GuilhermeBohnstedt/8bits-processor/README.md

# 8bits-processor
Trabalho de Conclusão do Curso de Eletrônica

## Objetivo

Queríamos entender melhor como processadores funcionam internamente. Para isso, estudamos a fundo teorias da computação e lógica booleana. Construímos um processador simples que faz os 4 cálculos básicos da matemática, usando somente portas lógicas e circuitos integrados básicos.

## Interpretador
Criamos também uma linguagem para nosso processador.
A partir de um montador, que também construímos, podemos converter instruções humanamente legíveis para códigos que o processador possa executar.

## Documento
Na pasta docs estão os documentos do projeto.

Documento téorico: [Leia aqui](https://github.com/GuilhermeBohnstedt/discrete-processor/blob/main/docs/doc.pdf)
