GuilhermeBohnstedt/8bits-processor/docs/apresetation.pptx

## Processador Prográmavel com circuitos discretos

Guilherme Bohnstedt
Lucas Seiji Kido

## Objetivo

O nosso projeto é um kit didático, com o objetivo de dar uma noção ao usuário de como funciona os processadores e ter uma pequena noção de programação, e o que acontece com a variável no programa.

## Operações Aritméticas

Todos as operações fundamentais (soma, subtração, multiplicação e divisão) podem ser realizadas utilizando apenas uma operação, a soma.

## Multiplicação

Multiplicação é uma série de somas com o mesmo número.
2 x 3 = 6 0010
2 + 2 + 2 = 6 0010
ou 0010
3 + 3 = 6 0110

## Subtração

Subtração é uma soma de dois números, um positivo e outro negativo. E para transformar um binário positivo em um binário negativo há dois modos de conseguir isso, por complemento de um e por complemento de dois.

## Subtração

- Complemento de Um.
Inverte todos os bits do número.
Ex.
1 - 00000001
-1 - 11111110

## Subtração

- Complemento de Dois.
Inverte todos os bits e soma um.
Ex.
1 - 00000001
-1 - 11111111

## Divisão

Divisão é uma série de subtrações até que o divisor seja maior que o dividendo, o resultado é a quantidade de subtrações realizadas e como a nossa calculadora não devolve valores reais não mexemos no resto.

## Processador

- Somador
- Unidade Lógica
- Controlador de pulsos
- Entrada
- Saída
- Memória

## ULA

É o circuito que só realiza soma em binário de duas variáveis, assim concluindo as operações fundamentais utilizando apenas soma, como mostrado anteriormente.

## Unidade Lógica

Onde realiza as quatro operações lógicas básicas, sim, não , e, ou.

SIM | | Mantem os bits no mesmo estado.
NÃO | | Inverte os bits.
E | | A saída só será 1 se as duas entradas forem 1.
OU | | A saída só será 1 se uma ou ambas entradas forem 1.

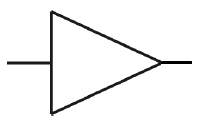
[picture p1: figure]
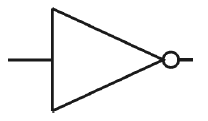
[picture p2: figure]
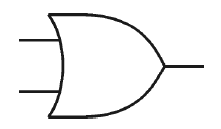
[picture p3: figure]

## Controlador de Pulsos

Controlador de pulsos é um circuito clock, que controla a quantidade que pulsos de clock que será necessário para realizar a operação programada.

## Entrada

Circuito onde o usuário pode colocar os dados manualmente, e dar as instruções que o processador realizará.

## Saída

É o dado em binário devolvido pelo processador das instruções em que ele realizou.

## Memória

O circuito de memória de programa possui uma eeprom que grava o código do programa. Um contador é responsável pela mudança de endereços. E dependendo da instrução esse circuito fica inativo.

## Manipulação dos Dados

Ao inserir os dados manualmente a variável fica registrada nos flip-flops e depois vai para um multiplexador com quatro saídas, uma para cada operação, e então é analisada que tipo de operação vai ser efetuado, ai então será decidido o que realizara com a variável.

## Manipulação de Dados

- Soma
Na soma a primeira variável vai para a ULA onde é somada com a saída que é zero, então obtemos uma saída com o valor da primeira variável. Após isso a segunda variável vai para a ULA onde se repete o processo, mas dessa vez somando a primeira com a segunda variável.

## Manipulação de Dados

- Subtração
A segunda variável é mandada para a ULA onde se realiza o complemento de 1, invertendo todos os bits dela, assim somando com a saída e o dado. Depois o primeiro dado é somado com o primeiro, resultando na saída que é somado com 1, realizando o complemento de 2 e na resposta.

## Manipulação de Dados

- Multiplicação
A primeira variável será quantas vezes a segunda variável será somada, por isso ela será como comparação no comparador. Então a segunda é somada com saída depois disso é incrementada a quantidade de vezes que ira ser somada. Logo depois de incrementar o comparador verifica se às vezes somada é igual ou menor que a primeira variável, se for menor o ciclo ocorre ate que seja igual e se for igual o ciclo acaba e devolve a resposta.

## Manipulação de Dados

- Divisão
A primeira variável será quantas vezes a segunda variável será somada, por isso ela será como comparação no comparador. Então a segunda é somada com saída depois disso é incrementada a quantidade de vezes que ira ser somada. Logo depois de incrementar o comparador verifica se às vezes somada é igual ou menor que a primeira variável, se for menor o ciclo ocorre ate que seja igual e se for igual o ciclo acaba e devolve a resposta.

## Conclusão

Podemos analisar como o processador funciona, assim podemos compreender melhor os circuitos integrados e como manipular os bits, para realizar operações aritméticas. Conseguimos uma noção o que o processador faz com as instruções que lhe é dada. Ter uma experiencia de como construir placas de circuito impresso, e utilizar o software Protheus. Obtivemos um amplo conhecimento de eletrônica digital.

## Referências

- http://www.tecmundo.com.br/tecnologia-da-informacao/1697-a-historia-dos-computadores-e-da-computacao.htm
- http://pt.wikipedia.org/wiki/Computador
- http://www.tecmundo.com.br/eletronica/45954-como-funciona-um-circuito-integrado-ilustracao-.htm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
