GuilhermeBohnstedt/8bits-processor/Interpretador/help2.jpg

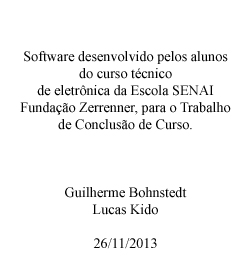
Interpretador/help2.jpg
