GuilhermeBohnstedt/8bits-processor/Interpretador/help.jpg

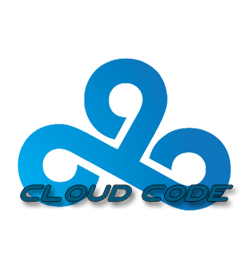
Interpretador/help.jpg
