GuilhermeBohnstedt/8bits-processor/Interpretador/help.png

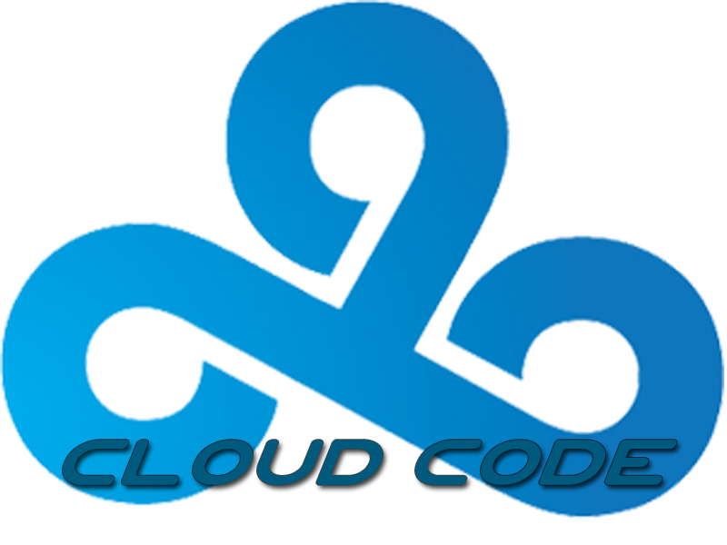
Interpretador/help.png
