GuilhermeBohnstedt/8bits-processor/somador/Somador Final/Somador Final.BMP

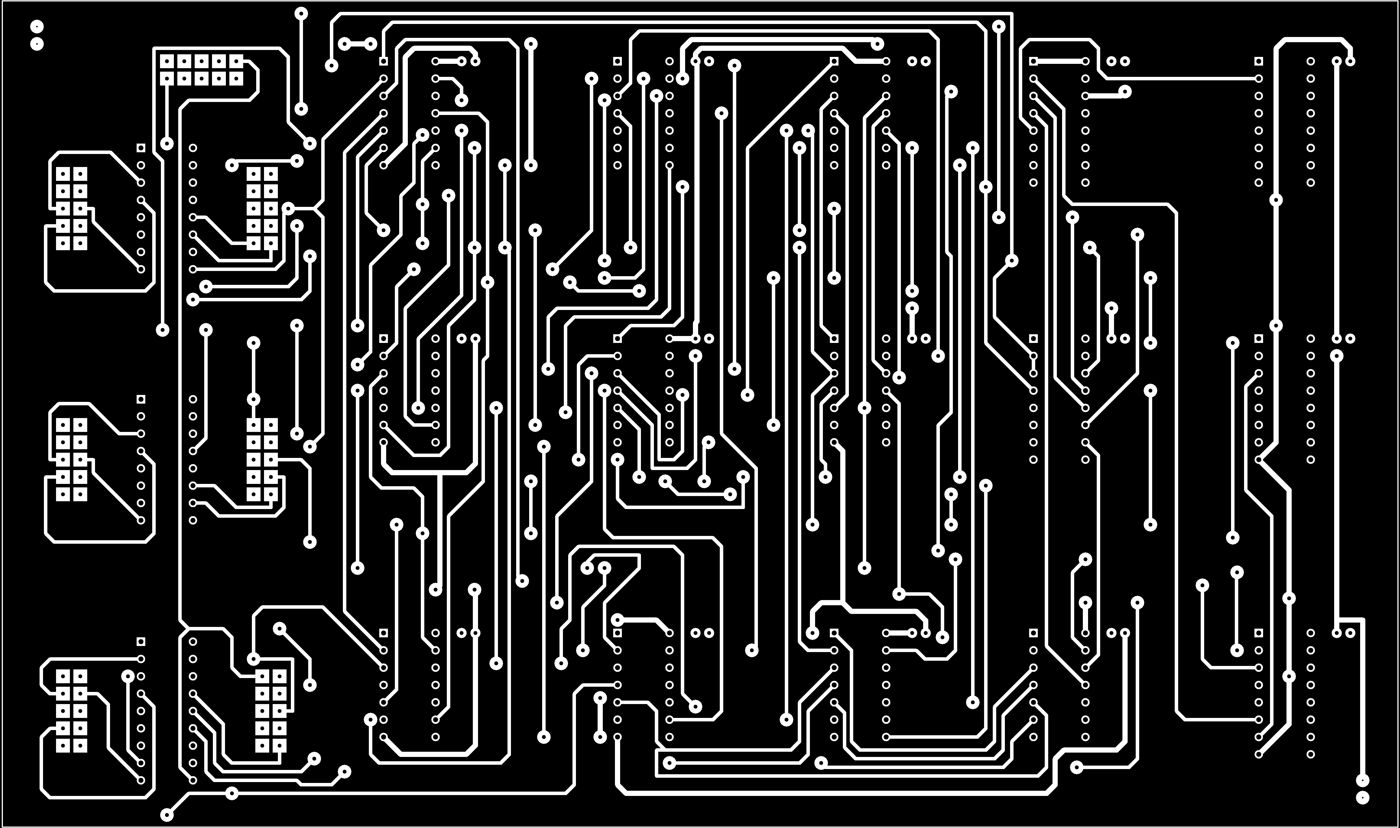
somador/Somador Final/Somador Final.BMP
