GuilhermeBohnstedt/8bits-processor/fonte/FONTE_LISTA_DE_MATERIAL.xls

Sheet: APROV_ EMPREND__NOVO
 |  |  |  |  |  | APROVAÇÃO DO |  |  |  |  |  |  |  |  |  |  |  | NÚMERO DA ATE |  |  |  |  |  |  | FOLHA No
 |  |  |  |  |  | ESTUDO/EMPREENDIMENTO
 |  |  |  |  |  |  |  |  |  |  |  |  |  |  |  |  |  | 9 | 4 | 5 | 0 | 6
ASSUNTO: |  |  | SINALIZAÇÃO INDEVIDA DE LINHA ENERGIZADA (FALHA K75120-K72052-K73503)
LOCAL |  |  |  |  |  |  | ABRANGÊNCIA |  |  |  |  |  | SOLICITANTE |  |  |  |  |  | DATA DA SOLICITAÇÃO
 | PSO |  |  |  |  |  |  | S/E PSO |  |  |  |  |  | GOP/OPT |  |  |  |  |  | 2004-03-10
JUSTIFICATIVA DA NECESSIDADE: |  |  |  |  |  |  |  |  |  |  | NORMALIZAR A SINALIZAÇÃO PARA CONFIABILIDADE DO
 | SISTEMA
CONSEQUÊNCIAS DO NÃO ATENDIMENTO: |  |  |  |  |  |  |  |  |  |  |  | A NÃO OPERACIONALIDADE DO SISTEMA COM
 | SEGURANÇA
ETAPAS PREVISTAS / VALORES ESTIMADOS
ETAPA |  |  |  | EXECUTANTE |  |  |  |  |  |  |  |  |  |  |  | MÃO-DE-OBRA |  |  |  |  |  |  |  | MATERIAL
N0 |  | TIPO |  | COORD. |  |  |  |  | SUPERV. |  |  | EQUIPE |  |  |  | (Hxh) |  |  | (UFESP) |  |  |  |  | (UFESP)
1 |  | AP |  | EPL |  |  |  |  | ELT |  |  |  |  |  |  | 8 |  |  | 32
2 |  | ET |  | EPL |  |  |  |  | ELT |  |  |  |  |  |  | 4 |  |  | 16
3 |  | EX |  | MTE |  |  |  |  | EMN |  |  | PRN |  |  |  | 4 |  |  | 8.84
4 |  | AF |  | EPL |  |  |  |  | ELT |  |  |  |  |  |  | 1 |  |  | 4
5
6
7
8
9
10
 |  |  |  |  |  |  |  |  |  |  |  | TOTAL |  |  |  | 17 |  |  | 60.84 |  |  |  |  | 0
 |  |  |  |  |  |  |  |  |  |  |  | TOTAL GERAL (UFESP) |  |  |  |  |  |  | 60.84
 |  |  |  |  | NÚMERO DO CONTRATO |  |  |  |  |  |  |  |  |  |  | NÚMERO DA OS
PROJETO
EXECUÇÃO
EXPECTATIVA DE ATENDIMENTO DO SOLICITANTE: |  |  |  |  |  |  |  |  |  |  |  |  |  |  |  |  |  |  |  | 30 |  | / | 06 |  | / | 04
PREVISÃO DE ENTREGA DO ESTUDO/EMPREENDIMENTO: |  |  |  |  |  |  |  |  |  |  |  |  |  |  |  |  |  |  |  | 30 |  | / | 06 |  | / | 04
COORDENAÇÃO RESPONSÁVEL: |  |  |  |  |  |  |  |  |  | MTC / EPL |  | RESPONSÁVEL: |  |  |  |  | GERSON R17628.5 |  |  |  |  |  |  | 2004-06-03
TIPO DE ATE |  |  |  |  |  |  |  |  |  |  | M.O. P/ESTUDO/PROJETO |  |  |  |  |  | NÍVEL DE APROVAÇÃO
ESTUDO/PROJETO |  |  |  |  |  |  |  |  |  |  | INTERNA |  |  |  |  |  | EPL |  |  |  |  |  | EPL
 |  |  |  |  |  |  |  |  |  |  |  |  |  |  |  |  | EPL |  |  |  |  |  | EPL
APROVAÇÃO
 | ________________ |  |  |  |  |  |  |  | ________________ |  |  |  |  |  | ___________________ |  |  |  |  |  |  | ________________
 | SUPERVISOR |  |  |  |  |  |  |  | COORDENADOR |  |  |  |  |  | CHEFE DE DPTO. |  |  |  |  |  |  | GERENTE
 | ____ /____ / ____ |  |  |  |  |  |  |  | _____ / ____ / ____ |  |  |  |  |  | ____ / ____ / ____ |  |  |  |  |  |  | ____ / ____ / ____

Sheet: PLANEJAMENTO DE ETAPAS_NOVO
 |  |  |  |  |  | PLANEJAMENTO DE ETAPAS |  |  |  |  |  |  |  |  | NÚMERO DA ATE |  |  |  |  |  |  | FOLHA No
 |  |  |  |  |  |  |  |  |  |  |  |  |  |  | 9 | 4 | 5 | 0 | 6
ASSUNTO: |  |  |  | SINALIZAÇÃO INDEVIDA DE LINHA ENERGIZADA (FALHA K75120-K72052-K73503)
LOCAL |  |  |  |  |  |  | ABRANGÊNCIA |  |  |  | SOLICITANTE |  |  |  |  | DATA DA SOLICITAÇÃO
 | PSO |  |  |  |  |  |  | S/E PSO |  |  |  | GOP/OPT |  |  |  |  | 2004-03-10
ETAPAS PREVISTAS / PRAZOS E VALORES ESTIMADOS
ETAPA |  |  |  |  | EXECUTANTE |  |  |  |  | DATA |  |  |  | MÃO-DE-OBRA |  |  |  |  |  |  | MATERIAL
N0 |  | TIPO |  |  | COORD |  | SUP |  | EQUIPE | INÍCIO |  |  | TÉRMINO | (Hxh) |  |  | (UFESP) |  |  |  | (UFESP)
1 |  | AP |  |  | EPL |  | ELT |  |  | 2004-06-03 |  |  | 2004-06-10 | 8 |  |  | 32 |  |  |  | 0
2 |  | ET |  |  | EPL |  | ELT |  |  | 2004-06-10 |  |  | 2004-06-20 | 4 |  |  | 16 |  |  |  | 0
3 |  | EX |  |  | MTE |  | EMN |  | PRN | 2004-06-20 |  |  | 2004-06-25 | 4 |  |  | 8.84 |  |  |  | 0
4 |  | AF |  |  | EPL |  | ELT |  |  | 2004-06-25 |  |  | 2004-06-30 | 1 |  |  | 4 |  |  |  | 0
5 |  |  |  |  |  |  |  |  |  |  |  |  |  | 0 |  |  | 0 |  |  |  | 0
6 |  |  |  |  |  |  |  |  |  |  |  |  |  | 0 |  |  | 0 |  |  |  | 0
7 |  |  |  |  |  |  |  |  |  |  |  |  |  | 0 |  |  | 0 |  |  |  | 0
8 |  |  |  |  |  |  |  |  |  |  |  |  |  | 0 |  |  | 0 |  |  |  | 0
9 |  |  |  |  |  |  |  |  |  |  |  |  |  | 0 |  |  | 0 |  |  |  | 0
10 |  |  |  |  |  |  |  |  |  |  |  |  |  | 0 |  |  | 0 |  |  |  | 0
 |  |  |  |  |  |  |  |  |  | TOTAL |  |  |  | 17 |  |  | 60.84 |  |  |  | 0
 |  |  |  |  |  |  |  |  |  | TOTAL GERAL (UFESP) |  |  |  |  |  |  | 60.84
ANUÊNCIA DOS ENVOLVIDOS
ETAPA |  |  | RESPONSÁVEL
N0 |  |  | REGISTRO |  |  | VISTO |  |  |  |  |  |  |  | DATA
1 |  |  | R 17628-5 |  |  |  |  |  |  |  |  |  |  | 2004-06-03
2 |  |  | R 17628-5 |  |  |  |  |  |  |  |  |  |  | 2004-06-03
3 |  |  | R 02235-1 |  |  |  |  |  |  |  |  |  |  | 2004-06-03
4 |  |  | R 17628-5 |  |  |  |  |  |  |  |  |  |  | 2004-06-03
5
6
7
8
9
10
EXPECTATIVA DE ATENDIMENTO DO SOLICITANTE: |  |  |  |  |  |  |  |  |  |  |  |  |  |  |  |  | 30 |  | / | 06 |  | / | 04
OBSERVAÇÕES:

Sheet: Listas
ETAPAS DOS SGAT |  |  | SUPERVISÕES MTC |  | COORDENAÇÕES MTC |  | ESTAÇÕES
 |  |  |  |  |  |  | N/S
AP | ANÁLISE PRÉVIA |  | PRE | 53232 | MTC / EPL | EPL
ET | ESTUDO TÉCNICO |  | PRM | 53234 | MTC / EPN | EPN | PAT
PR | PROJETO |  | ELT | 53231 | MTC / EPV | EPV | JAB
APM | APROVIS. DE MATERIAL |  | MEC | 53233 | MTC / EPC | EPC | CON
EX | EXECUÇÃO |  | EDP |  |  | CNT | JUD
AF | AVALIAÇÃO FINAL |  |  |  |  |  | SAL
CT | CONTRATAÇÃO |  |  |  |  |  | ARV
VL | VALORAÇÃO |  |  |  |  |  | SCZ
 |  |  |  |  |  |  | VMN
RESPONSÁVEIS |  | RG´S |  | TIPO DE ATE | MÃO DE OBRA |  | ANR
 |  |  |  |  |  |  | PSO
EPL |  |  |  | ESTUDO/PROJETO | INTERNA |  | VGO
CATUTA R05676-0 |  | R05676-0 |  | EMPREENDIMENTO | EXTERNA |  | JQM
 |  |  |  |  |  |  | LIB
PRE |  |  |  |  |  |  | PSE
SASSON R17319-7 |  | R17319-7 |  |  |  |  | BTO
MOITA R13801-4 |  | R13801-4 |  |  |  |  | LUZ
ORIEL R19833-5 |  | R19833-5 |  |  |  |  | TRD
SÉRGIO R19175-6 |  | R19175-6 |  |  |  |  | ARM
NAKO R07896-8 |  | R07896-8 |  |  |  |  | TTE
 |  |  |  |  |  |  | CDU
ELT |  |  |  |  |  |  | SAN
VASCONCELOS R07972-7 |  | R07972-7 |  |  |  |  | JPA
NAKANO R13352-7 |  | R13352-7 |  |  |  |  | PIG
DIMAN R15982-8 |  | R15892-8 |  |  |  |  | TUC
RUBENS R18289-7 |  | R18289-7
REDONDO R18173-4 |  | R18173-4 |  |  |  |  | L/O
LEONEL R15006-5 |  | R15006-5
NASCIMENTO R09308-8 |  | R09308-8 |  |  |  |  | PIT
MAGNO R12401-3 |  | R12401-3 |  |  |  |  | ITQ
ABNER R19031-8 |  | R19031-8 |  |  |  |  | ART
GERSON R17628-5 |  | R17628-5 |  |  |  |  | PCA
LEANDRO R22238-4 |  | R22238-4 |  |  |  |  | VTD
NOBORU R083945 |  | R08394-5 |  |  |  |  | VPA
IVAN R172794 |  | R17279-4 |  |  |  |  | PEN
LIUDI R14678-5 |  | R14678-5 |  |  |  |  | CAR
 |  |  |  |  |  |  | TAT
PRM |  |  |  |  |  |  | BEL
ROBERTO R06120-8 |  | R06120-8 |  |  |  |  | BRE
CAETANO R19804-1 |  | R19804-1 |  |  |  |  | BAS
DAGOBERTO R15547-4 |  | R15547-4 |  |  |  |  | PDS
CARLOS R07780-5 |  | R07780-5 |  |  |  |  | PSE
MARJORIE R14557-6 |  | R14557-6 |  |  |  |  | GBU
 |  |  |  |  |  |  | REP
MEC |  |  |  |  |  |  | CEC
RICARDO R13955-0 |  | R13955-0 |  |  |  |  | DEO
MOYSÉS R02063-3 |  | R02063-3 |  |  |  |  | BFU
EDGARD R15419-2 |  | R15419-2
REINALDO R14906-7 |  | R14906-7 |  |  |  |  | PAULISTA
ROGER R08700-2 |  | R08700-2
CÁSSIO R18955-7 |  | R18955-7 |  |  |  |  | ANR
CAMPELLO R172387 |  | R17238-7 |  |  |  |  | PSO
KAZUO R02014-5 |  | R02014-5 |  |  |  |  | BGD
GABRIEL R22235-0 |  | R22235-0 |  |  |  |  | TRI
 |  |  |  |  |  |  | CNS
CPQ |  |  |  |  |  |  | CLS
MAURO R15554-7 |  | R15554-7 |  |  |  |  | SUM
 |  |  |  |  |  |  | VMD

Sheet: ANÁLISE CRÍTICA
 | ANÁLISE CRÍTICA, VERIFICAÇÃO E VALIDAÇÃO | NÚMERO DA ATE |  |  |  |  | FOLHA No
 |  | 9 | 4 | 5 | 0 | 6
ANÁLISE CRÍTICA
Planejamento:
Resultados:
VERIFICAÇÃO
Planejamento:
Resultados:
VALIDAÇÃO
Planejamento:
Resultados:

Sheet: A_P_ TERCEIROS
 |  |  |  |  |  |  | SOLICITAÇÃO DE |  |  |  |  |  |  |  |  |  |  |  | NÚMERO DA ATE |  |  |  |  |  | FOLHA No
 |  |  |  |  |  |  | ANÁLISE PRÉVIA
 |  |  |  |  |  |  |  |  |  |  | PARA ATE MISTA |  |  |  |  |  |  |  | 9 | 4 | 5 | 0 | 6
DE: |  | ENG. NAKO |  |  |  |  |  |  |  | COORD.: |  |  | EPL |  |  | ÁREA: | PRE |  |  |  |  | DATA: |  | 2002-06-06
PARA: |  |  | ENG. LOVATO |  |  |  |  |  |  |  |  | COORD.: |  | EPC |  |  |  | ÁREA: |  |  | EDP
ASSUNTO: |  |  |  | SINALIZAÇÃO INDEVIDA DE LINHA ENERGIZADA (FALHA K75120-K72052-K73503)
 | 0
 | 0
SERVIÇOS SOLICITADOS: |  |  |  |  |  |  |  |  | CONSTRUÇÃO BASES DE CONCRETO PARA FIXAÇÃO DE 4 POSTES COM
 | ALTURA MÁXIMA DE 3,5M.
DATA LIMITE PARA ENVIO DO PARECER TÉCNICO PELA COORDENAÇÃO RESPONSÁVEL: |  |  |  |  |  |  |  |  |  |  |  |  |  |  |  |  |  |  |  |  |  |  |  |  | / /
VALORES/PRAZOS ESTIMADOS PELO EP ENVOLVIDO:
ETAPA |  |  |  |  | EXECUTANTE |  |  |  |  |  |  |  | DATA |  |  |  |  | MÃO-DE-OBRA |  |  |  |  |  | MATERIAL
N0 |  | TIPO |  |  | COORD |  |  | SUP |  |  | EQUIPE |  | INÍCIO |  |  | TÉRMINO |  | (Hxh) |  |  | (UFESP) |  |  | (UFESP)
1 |  | AP |  |  | EPL |  |  | ELT |  |  | 0 |  | 2004-06-03 |  |  | 2004-06-10 |  | 8 |  |  | 32
2 |  | ET |  |  | EPL |  |  | ELT |  |  | 0 |  | 2004-06-10 |  |  | 2004-06-20 |  | 4 |  |  | 16
3 |  | EX |  |  | MTE |  |  | EMN |  |  | PRN |  | 2004-06-20 |  |  | 2004-06-25 |  | 4 |  |  | 8.84
4 |  | AF |  |  | EPL |  |  | ELT |  |  | 0 |  | 2004-06-25 |  |  | 2004-06-30 |  | 1 |  |  | 4
5 |  | 0 |  |  | 0 |  |  | 0 |  |  | 0 |  | 0 |  |  | 0 |  | 0 |  |  | 0
6 |  | 0 |  |  | 0 |  |  | 0 |  |  | 0 |  | 0 |  |  | 0 |  | 0 |  |  | 0
7 |  | 0 |  |  | 0 |  |  | 0 |  |  | 0 |  | 0 |  |  | 0 |  | 0 |  |  | 0 |  |  | 0
8
9
10
OBSERVAÇÕES:
ANUÊNCIA DO EP ENVOLVIDO
RESPONSÁVEL |  |  |  |  |  |  |  |  |  |  | SUPERVISOR |  |  |  |  |  |  | COORDENADOR
VISTO: |  |  |  |  |  |  |  |  |  |  | VISTO: |  |  |  |  |  |  | VISTO:
REGISTRO: |  |  |  |  |  |  |  |  |  |  | REGISTRO: |  |  |  |  |  |  | REGISTRO:
DATA: |  |  |  |  |  |  |  |  |  |  | DATA: |  |  |  |  |  |  | DATA:
 |  |  | / |  |  | / |  |  |  |  |  |  | / |  | / |  |  |  |  |  |  | / |  | /

Sheet: REM1
 |  |  |  |  |  |  |  |  |  |  | ANEXO No
 |  |  |  |  | LISTA DE MATERIAL
ASSUNTO: |  | FONTE DE TENSÃO C/ SAÍDA REGULÁVEL 0 A 20 Vcc E FIXA DE 5 Vcc E 12 Vcc
Item | Código | Unid | Quant | Descrição |  |  | Valores Estimados(R$) |  | Valores Reais (R$) |  | Disp. Mat.
 |  |  |  |  |  |  | Unitário | Total | Unitário | Total | Previsto | Real
1 | TR1 | PÇA | 1 | TRANSFORMADOR 110/220V 9+9V 2A
2 | Q2 | PÇA | 1 | TRANSISTOR BC 548
3 | Q1 | PÇA | 1 | TRANSISTOR TIP 125 C/ DISSIPADOR DE CALOR E PARAFUSO DE FIXAÇÃO
4 | U1 | PÇA | 1 | REGULADOR DE TENSÃO 7812
5 | U2 | PÇA | 1 | REGULADOR DE TENSÃO 7805
6 | D1 A D9 | PÇA | 9 | DIODO RETIFICADOR 1N4004
7 | DZ1 | PÇA | 1 | DIODO ZENER 1N4747
8 | LED1, LED2 | PÇA | 2 | LED VERMELHO C/ SUPORTE PARA PAINEL
9 | C1 | PÇA | 1 | CAPACITOR ELETROLÍTICO RADIAL 2200 µF – 35V
10 | C4 | PÇA | 1 | CAPACITOR ELETROLÍTICO RADIAL 1000 µF – 35V
11 | C2 | PÇA | 1 | CAPACITOR ELETROLÍTICO RADIAL 10 µF – 25V
12 | C3, C5 | PÇA | 2 | CAPACITOR ELETROLÍTICO RADIAL 0,1 µF – 25V
13 | R4 | PÇA | 1 | RESISTOR 470 Ω- 2W
14 | R1 | PÇA | 1 | RESISTOR 1k8 Ω- 1W
15 | R2 | PÇA | 1 | RESISTOR 470 Ω- 0,5W
16 | R3 | PÇA | 1 | RESISTOR 1k5 Ω- 0,5W
17 | R5 | PÇA | 1 | RESISTOR 3k3 Ω- 0,5W
18 | P1 | PÇA | 1 | POTENCIÔMETRO LINEAR 50 kΩ COM KNOB
19 | FU1 | PÇA | 1 | FUSÍVEL DE VIDRO DE 2A C/ PORTA FUSÍVEL DE PAINEL
20 | CH2 | PÇA | 1 | CHAVE HH 110/220 V
21 | CH1 | PÇA | 1 | CHAVE LIGA DESLIGA SIMPLES PARA PAINEL
22 | B1, B3, B4 | PÇA | 3 | BORNE VERMELHO PARA PAINEL
23 | B2, B5 | PÇA | 2 | BORNE PRETO PARA PAINEL
24 | - | PÇA | 1 | CABO DE ALIMENTAÇÃO (CORDÃO DE FORÇA C/ PLUG)
25 | - | PÇA | 1 | PLACA DE CIRCUITO IMPRESSO COBREADA 1 FACE TAMANHO 12 X 5,5 CM
26 | - | PÇA | 1 | CAIXA PLÁSTICA PARA MONTAGEM DOS COMPONENTES TAMANHO MINIMO 14X9X10 CM |  |  | - | #VALUE!
27 | - | MTR | 1 | CABO DE CONTROLE FLEXIVEL 0,5 MM2 600V |  |  | - | #VALUE!
28 |  | #N/A |  |  |  |  | #N/A
29 |  | #N/A |  |  |  |  | #N/A
30 |  | #N/A |  |  |  |  | #N/A
 |  |  |  |  |  |  |  | #VALUE!
EXECUTANTE |  |  |  |  | NÚMERO | TURMA | COMPONENTE CURRICULAR |  |  | PROFº
 |  |  |  |  |  |  | MSI – II |  |  | GERSON

Sheet: OSES
 |  |  | ORIENTAÇÃO E SEQUÊNCIA DE |  |  |  | NÚMERO DA ATE |  |  |  |  |  | FOLHA No
 |  |  | EXECUÇÃO DE SERVIÇOS
 |  |  | OSES |  |  |  | 9 | 4 | 5 | 0 | 6
ASSUNTO: |  | SINALIZAÇÃO INDEVIDA DE LINHA ENERGIZADA (FALHA K75120-K72052-K73503)
0
0
0
ORIENTAÇÃO E SEQUÊNCIA DE EXECUÇÃO DO SERVIÇO
ITEM | EXECUTANTE COORD/SUP/EQUIP |  | ORIENTAÇÃO (IT,DESENHOS, ETC.) |  |  |  |  |  |  |  | RELAÇÃO DE MATERIAL |  |  | SEQ.
1 | MTE/CCV |  | EXECUTAR INSTALAÇÕES ELÉTRICAS CONFORME |  |  |  |  |  |  |  | REM 1 |  |  | 1
 |  |  | INDICADO NO DES. MTC 2AG002945
2 | MTE/CCV |  | EXECUTAR INSTALAÇÕES ELÉTRICAS CONFORME |  |  |  |  |  |  |  | REM 1 |  |  | 1
 |  |  | INDICADO NO DES. MTC 2AG002945
3 | MTE/CCV |  | EXECUTAR INSTALAÇÕES ELÉTRICAS CONFORME |  |  |  |  |  |  |  | REM 1 |  |  | 1
 |  |  | INDICADO NO DES. MTC 2AG002945
4 | MTE/CCV |  | EXECUTAR INSTALAÇÕES ELÉTRICAS CONFORME |  |  |  |  |  |  |  | REM 1 |  |  | 1
 |  |  | INDICADO NO DES. MTC 2AG002945
5 | MTE/CCV |  | EXECUTAR INSTALAÇÕES ELÉTRICAS CONFORME |  |  |  |  |  |  |  | REM 1 |  |  | 1
 |  |  | INDICADO NO DES. MTC 2AG002945
DISCRIMINAÇÃO DA MÃO-DE-OBRA E DISTRIBUIÇÃO DO Hxh PARA EXECUÇÃO
ITEM | CARGO |  |  | QUANTIDADE |  | TOTAL |  |  |  |  |  | MATERIAL
 |  |  |  | HOMENS | HORAS | Hxh |  |  | UFESP |  |  | (UFESP)
1 | Eletricista pleno |  |  | 1 | 1 | 1.00 |  |  | #VALUE! |  |  | #VALUE!
 | Supervisor de manutenção |  |  | 1 | 1 | 1.00 |  |  | #VALUE!
 | Eletricista de equip.especiais |  |  | 1 | 1 | 1.00 |  |  | #VALUE!
 | Técnico Manutenção Corretiva |  |  | 1 | 1 | 1.00 |  |  | #VALUE!
 | TOTAL |  |  | 4 |  | 4.00 |  |  | #VALUE!
2 | Eletricista pleno |  |  | 1 | 1 | 1.00 |  |  | #VALUE! |  |  | #VALUE!
 | Ajudante de almoxarifado |  |  | 1 | 1 | 1.00 |  |  | #VALUE!
 | Ajudante de almoxarifado |  |  | 1 | 1 | 1.00 |  |  | #VALUE!
 | Ajudante de almoxarifado |  |  | 1 | 1 | 1.00 |  |  | #VALUE!
 | TOTAL |  |  | 4 |  | 4.00 |  |  | #VALUE!
3 | Ajudante de almoxarifado |  |  | 1 | 1 | 1.00 |  |  | #VALUE! |  |  | 224.54
 | Eletricista de equip.especiais |  |  | 1 | 1 | 1.00 |  |  | #VALUE!
 | Eletricista especializado |  |  | 1 | 1 | 1.00 |  |  | #VALUE!
 | Técnico Manutenção Corretiva |  |  | 1 | 1 | 1.00 |  |  | #VALUE!
 | TOTAL |  |  | 4 |  | 4.00 |  |  | #VALUE!
4 | Eletricista |  |  | 1 | 1 | 1.00 |  |  | #VALUE! |  |  | 225.54
 | Eletromecânico especializado |  |  | 2 | 1 | 2.00 |  |  | #VALUE!
 | Eletricista especializado |  |  | 3 | 1 | 3.00 |  |  | #VALUE!
 | Usinador ferramenteiro |  |  | 4 | 1 | 4.00 |  |  | #VALUE!
 | TOTAL |  |  | 10 |  | 10.00 |  |  | #VALUE!
5 | Técnico Informática II |  |  | 13 | 1 | 13.00 |  |  | #VALUE! |  |  | 226.54
 | Técnico Manutenção Corretiva |  |  | 14 | 1 | 14.00 |  |  | #VALUE!
 | Técnico Manutenção |  |  | 15 | 1 | 15.00 |  |  | #VALUE!
 | Marceneiro |  |  | 16 | 1 | 16.00 |  |  | #VALUE!
 | TOTAL |  |  | 58 |  | 58.00 |  |  | #VALUE!
 |  |  |  | TOTAL PARCIAL |  | 76.00 |  |  | #VALUE! |  |  | #VALUE!
 |  |  |  | TOTAL GERAL - UFESP |  |  |  |  | #VALUE!

Sheet: HISTÓRICO
 |  |  | NÚMERO DA ATE |  |  |  |  | FOLHA No
 |  | HISTÓRICO
 |  |  | 9 | 4 | 5 | 0 | 6
DATA | DESCRIÇÃO
1999-11-11 | NENHUM FATO RELEVANTE A RELATAR.

Sheet: IDG
 |  | INDICE DE |  |  | NÚMERO DA ATE |  |  |  |  | FOLHA No
 |  | DOCUMENTOS
 |  | GERADOS |  |  | 9 | 4 | 5 | 0 | 6
ANEXO | DOCUMENTO N0 |  | REV. | DESCRIÇÃO |  |  |  |  |  |  | EX.
1 | MTC 2AG002945 |  | 0 | DESENHO DE INSTALAÇÃO ELÉTRICA |  |  |  |  |  |  | X
2 | REM 01 |  | 0 | RELAÇÃO DE MATERIAIS |  |  |  |  |  |  | X

Sheet: AVALIAÇÃO FINAL_EP_S
 |  |  |  |  | AVALIAÇÃO FINAL |  |  |  |  |  | NÚMERO DA ATE |  |  |  |  | FOLHA No
 |  |  |  |  |  |  |  |  |  |  | 9 | 4 | 5 | 0 | 6
ASSUNTO: |  |  | SINALIZAÇÃO INDEVIDA DE LINHA ENERGIZADA (FALHA K75120-K72052-K73503)
 | 0
 | 0
 | 0
ETAPAS PREVISTAS / PRAZOS ESTIMADOS x PRAZOS REAIS
ETAPA |  |  |  | DATA PREVISTA |  |  |  |  | DATA REAL
N0 |  | TIPO |  | INÍCIO |  |  | TÉRMINO |  | INÍCIO |  |  |  |  | TÉRMINO
1 |  | AP |  | 2004-06-03 |  |  | 2004-06-10 |  | / / |  |  |  |  | / /
2 |  | ET |  | 2004-06-10 |  |  | 2004-06-20 |  | / / |  |  |  |  | / /
3 |  | EX |  | 2004-06-20 |  |  | 2004-06-25 |  | / / |  |  |  |  | / /
4 |  | AF |  | 2004-06-25 |  |  | 2004-06-30 |  | / / |  |  |  |  | / /
5 |  | 0 |  | 0 |  |  | 0 |  | / / |  |  |  |  | / /
6 |  | 0 |  | 0 |  |  | 0 |  | / / |  |  |  |  | / /
7 |  | 0 |  | 0 |  |  | 0 |  | / / |  |  |  |  | / /
8 |  | 0 |  | 0 |  |  | 0 |  | / / |  |  |  |  | / /
9 |  | 0 |  | 0 |  |  | 0 |  | / / |  |  |  |  | / /
10 |  | 0 |  | 0 |  |  | 0 |  | / / |  |  |  |  | / /
ETAPAS PREVISTAS / VALORES ESTIMADOS x VALORES REAIS
ETAPA |  |  |  | MÃO-DE-OBRA |  |  |  |  |  |  |  |  | MATERIAL
 |  |  |  | PREVISTA |  |  |  | REAL |  |  |  |  | PREVISTO |  |  | REAL
N0 |  | TIPO |  | (Hxh) |  | (UFESP) |  | (Hxh) |  | (UFESP) |  |  | (UFESP) |  |  | (UFESP)
1 |  | AP |  | 8 |  | 32 |  |  |  |  |  |  | 0
2 |  | ET |  | 4 |  | 16 |  |  |  |  |  |  | 0
3 |  | EX |  | 4 |  | 8.84 |  |  |  |  |  |  | 0
4 |  | AF |  | 1 |  | 4 |  |  |  |  |  |  | 0
5 |  | 0 |  | 0 |  | 0 |  |  |  |  |  |  | 0
6 |  | 0 |  | 0 |  | 0 |  |  |  |  |  |  | 0
7 |  | 0 |  | 0 |  | 0 |  |  |  |  |  |  | 0
8 |  | 0 |  | 0 |  | 0 |  |  |  |  |  |  | 0
9 |  | 0 |  | 0 |  | 0 |  |  |  |  |  |  | 0
10 |  | 0 |  | 0 |  | 0 |  |  |  |  |  |  | 0
TOTAL
OBSERVAÇÕES:
 |  | RESPONSÁVEL |  |  |  |  | SUPERVISOR |  |  |  | COORDENADOR
 |  | ____/____ /____ |  |  |  |  | ____/____ /____ |  |  |  | ____/____ /____
