GuilhermeBohnstedt/8bits-processor/(list of files, cad)

Other CAD files:
Interpretador/Interpretador.obj
Interpretador/gravador.obj
Interpretador/sobre.obj
Interpretador/Programa.obj
