GuilhermeBohnstedt/8bits-processor/docs/Algoritmo.pdf

S

N

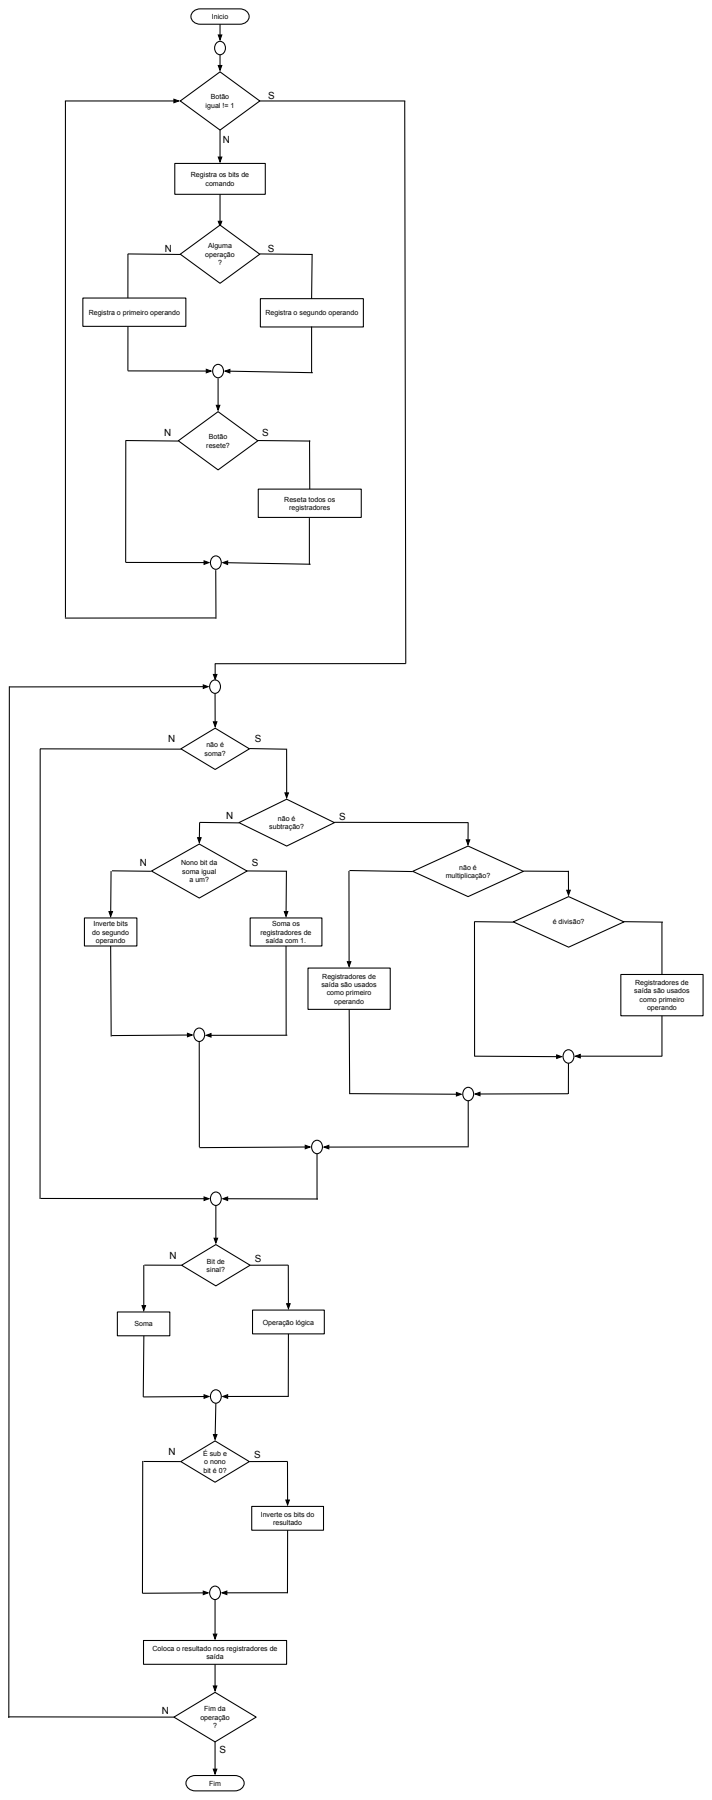
[picture p16: page 1]
Inicio; Botão igual != 1; não é soma?; não é subtração?; não é multiplicação?; Soma os; é divisão?; registradores de saída com 1.; Alguma operação ?; Botão resete?; Inverte bits do segundo operando; Bit de sinal?; Soma; Operação lógica; É sub e o nono bit é 0?; saída; Fim da operação ?; Fim

Registra os bits de
comando

Registra o primeiro operando

Registra o segundo operando

Reseta todos os
registradores

Nono bit da
soma igual

Registradores de
saída são usados
como primeiro
operando

Inverte os bits do
resultado

Coloca o resultado nos registradores de
