GuilhermeBohnstedt/8bits-processor/docs/ProjetoFinal v2.0.PDF

U29:A

U29:B

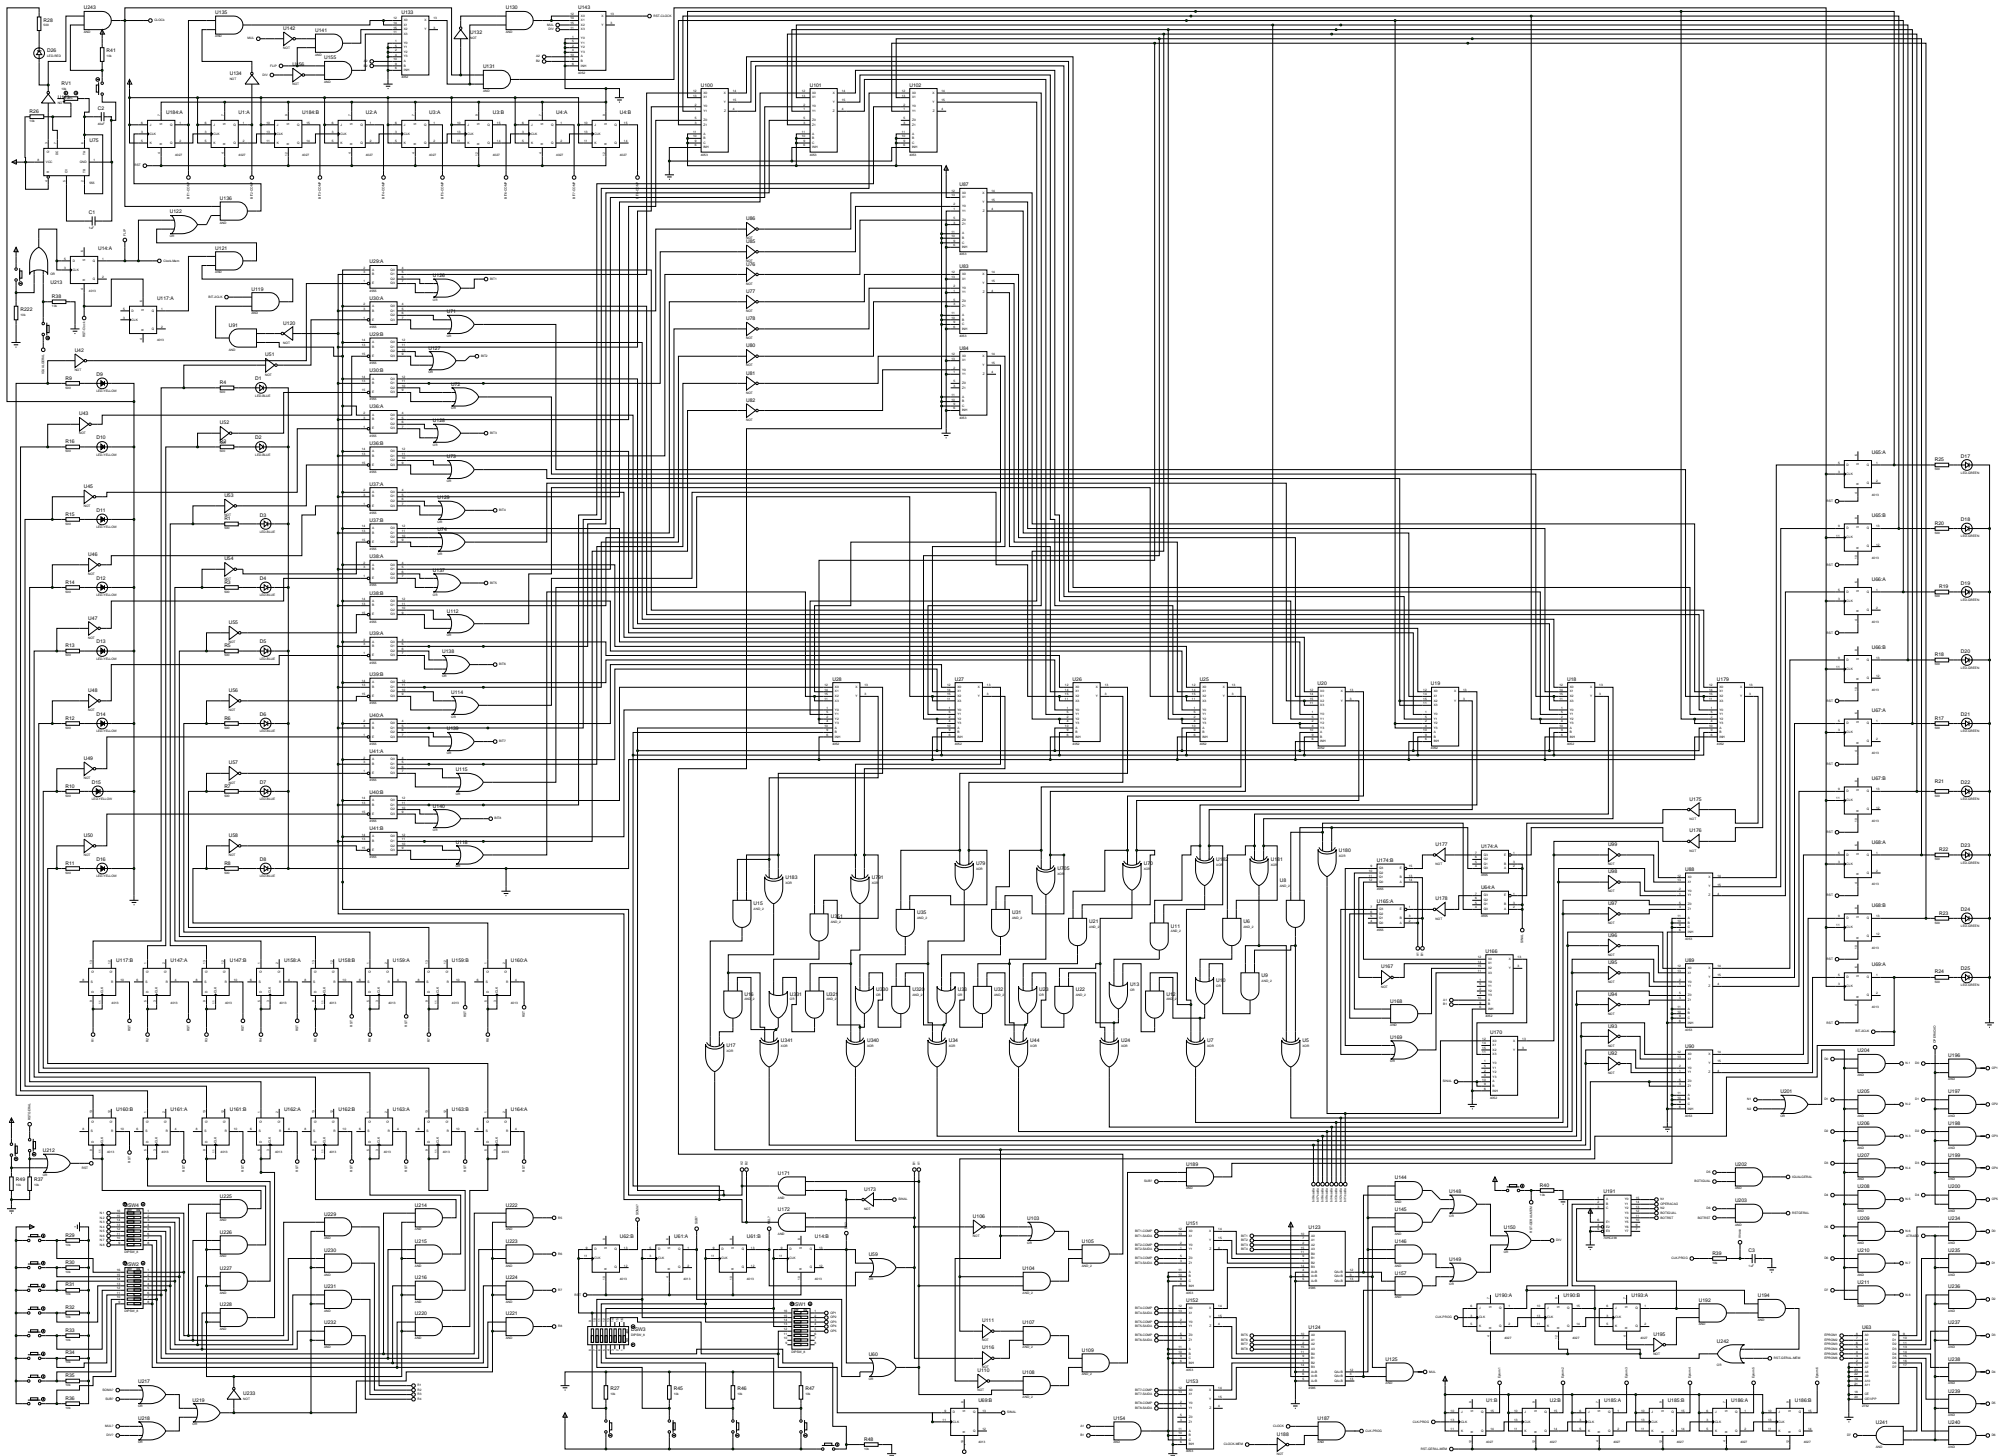
[picture p17: page 1]
