GuilhermeBohnstedt/8bits-processor/fonte/fonte_Completa_3_CIRCUITO_50.pdf

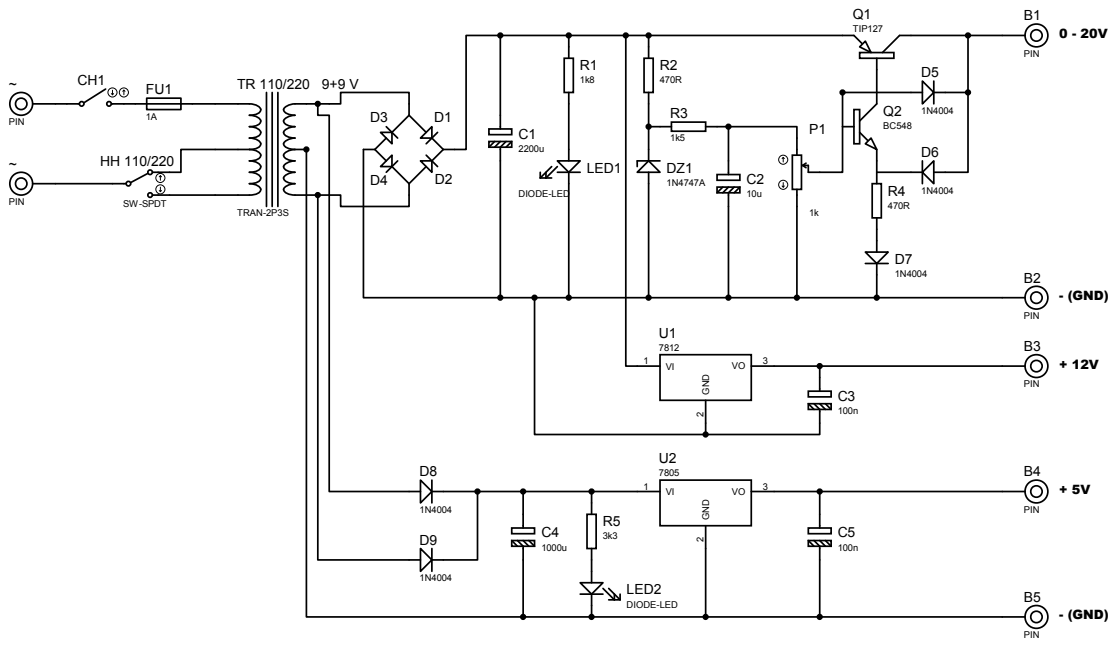
[picture p18: page 1]
