GuilhermeBohnstedt/8bits-processor/somador/Somador Final/Somador Final.PDF

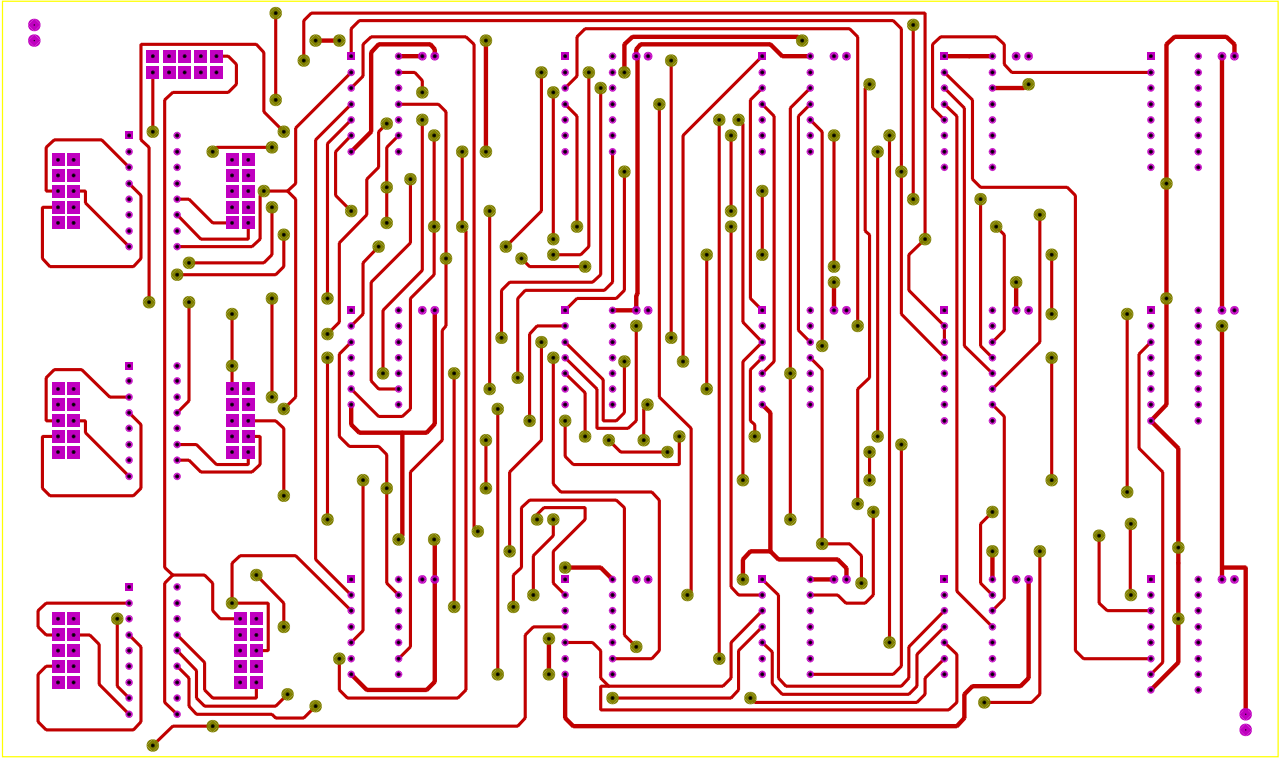
[picture p19: page 1]
