GuilhermeBohnstedt/8bits-processor/(list of files, drawings)

Other design files:
docs/ProjetoFinal v2.0.pdsprj
entrada/Entrada Final.DSN
entrada/Entrada Final.LYT
memoria/Memória.DSN
saida/Saída Final.DSN
somador/Somador Final/Somador Final.DSN
somador/Somador Final/Somador Final.LYT
somador/somador.LYT
somador/TCC.DSN
somador/TCC.LYT
